ankit-buru/rice-fern-microclimate-monitor/README.md

# rice-fern-microclimate-monitor
Creating a PCB for a device to monitor the microclimate around resurrection ferns.
