ankit-buru/rice-fern-microclimate-monitor/hardware/lte_board/pcb_render_bottom.png

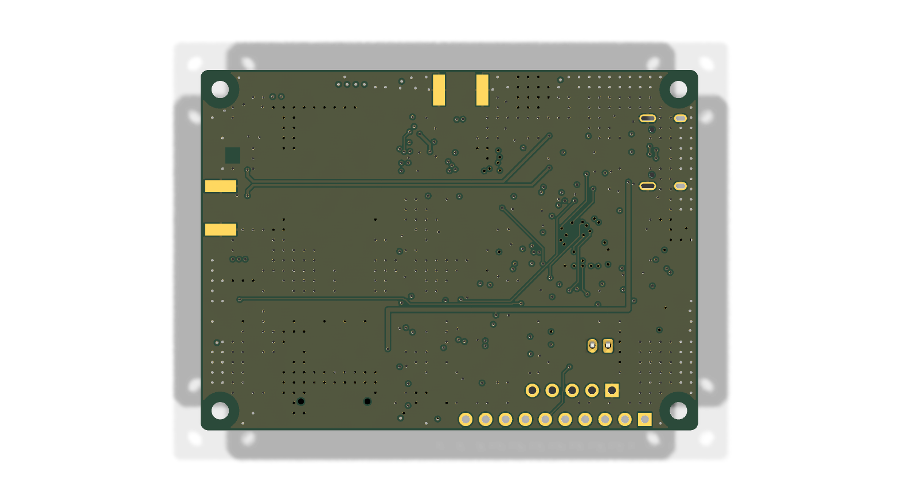
hardware/lte_board/pcb_render_bottom.png
