ankit-buru/rice-fern-microclimate-monitor/hardware/lte_board/schematic_preview.png

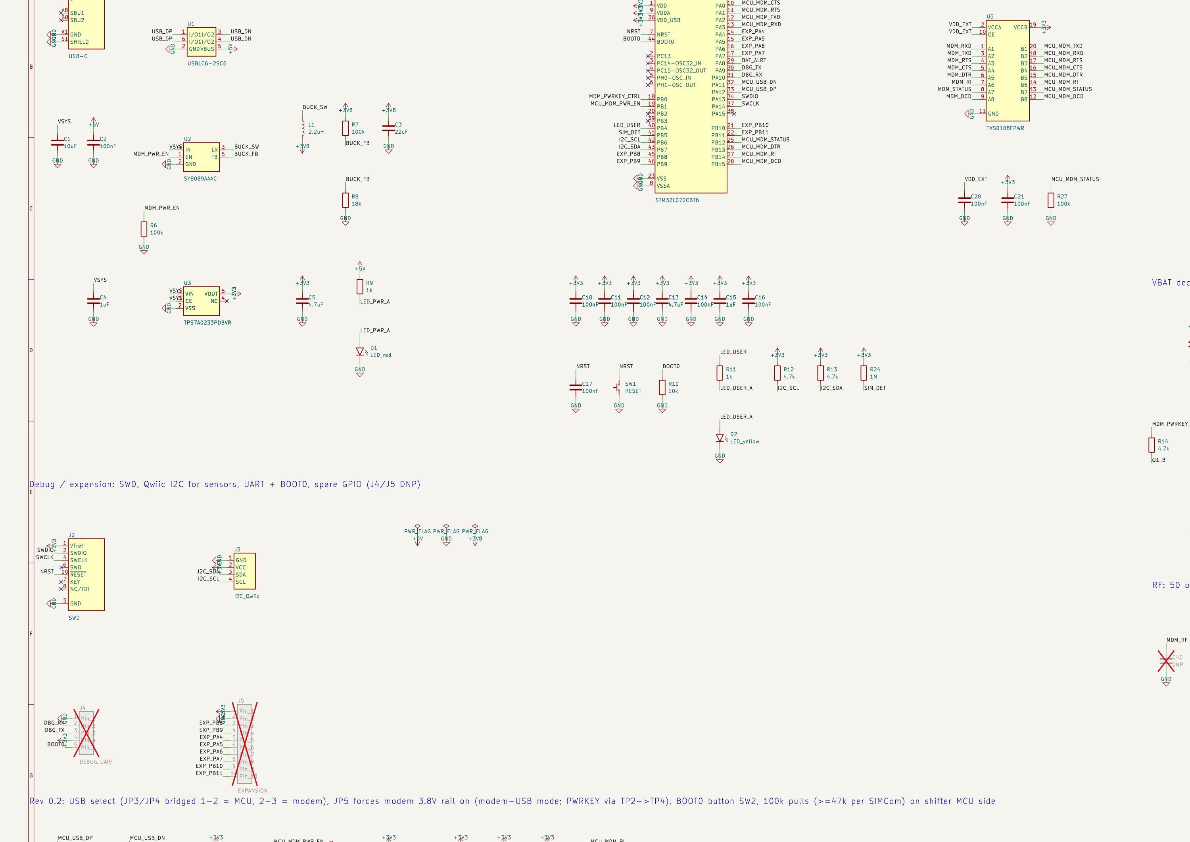
hardware/lte_board/schematic_preview.png
