ankit-buru/rice-fern-microclimate-monitor/hardware/lte_board/bom_jlcpcb.csv

Comment | Designator | Footprint | LCSC Part # | MPN | Qty
10uF | C1 | C_0805_2012Metric | C15850 | CL21A106KAYNNNE | 1
100nF | C2,C10,C11,C12,C14,C16,C17,C20,C21,C32,C35,C43,C50,C57,C60,C62 | C_0402_1005Metric | C1525 | CL05B104KO5NNNC | 16
22uF | C3 | C_0805_2012Metric | C45783 | CL21A226MAQNNNE | 1
1uF | C4,C15,C44 | C_0402_1005Metric | C52923 | CL05A105KA5NQNC | 3
4.7uF | C5,C13 | C_0603_1608Metric | C19666 | CL10A475KO8NNNC | 2
100uF | C30 | C_1206_3216Metric | C15008 | CL31A107MQHNNNE | 1
10uF | C31,C45 | C_0603_1608Metric | C19702 | CL10A106KP8NNNC | 2
33pF | C33,C51,C52,C53 | C_0402_1005Metric | C1562 | 0402CG330J500NT | 4
10pF | C34,C54,C55 | C_0402_1005Metric | C32949 | CL05C100JB5NNNC | 3
100pF | C56,C61 | C_0402_1005Metric | C1546 | 0402CG101J500NT | 2
LED_red | D1 | LED_0603_1608Metric | C2286 | KT-0603R | 1
LED_yellow | D2 | LED_0603_1608Metric | C2287 | KT-0603Y | 1
LED_green | D3 | LED_0603_1608Metric | C12624 | KT-0603G | 1
B5819W | D4 | D_SOD-123 | C8598 | B5819W SL | 1
WE05DGCF-B | D5,D8 | DFN1006-2L-BI | C3039401 | WE05DGCF-B | 2
ESD103-B1-02EL | D6 | TSLP-2-20_L1.0-W0.6-P0.65-BI | C535146 | ESD103-B1-02EL E6327 | 1
ESD5651N-2/TR | D7 | DFN1006-2L-BI-1 | C239784 | ESD5651N-2/TR | 1
USB-C | J1 | USB_C_Receptacle_HRO_TYPE-C-31-M-12 | C165948 | TYPE-C-31-M-12 | 1
SWD | J2 | PinHeader_2x05_P1.27mm_Vertical_SMD | C3975188 | PZ127-2-05-S | 1
I2C_Qwiic | J3 | JST_SH_SM04B-SRSS-TB_1x04-1MP_P1.00mm_Horizontal | C145956 | 1.0T-4P (BOOMELE) | 1
LTE_ANT | J6 | U.FL_Hirose_U.FL-R-SMT-1_Vertical | C88374 | U.FL-R-SMT-1(80) | 1
Nano-SIM | J8 | SIM-SMD_SMN-303 | C266888 | SMN-303 | 1
BATTERY | J9 | JST_PH_B2B-PH-K_1x02_P2.00mm_Vertical | C5251182 | B2B-PH-K-S-GW | 1
2.2uH | L1 | L_Sunlord_SWPA4030S | C279948 | SWPA4030S2R2NT | 1
47nH | L2 | L_0402_1005Metric | C192855 | LQW15AN47NJ00D | 1
MMBT3904 | Q1,Q2 | SOT-23 | C20526 | MMBT3904 | 2
AO3401A | Q3,Q4 | SOT-23 | C15127 | AO3401A | 2
FS8205A | Q5 | SOT-23-6 | C908265 | FS8205A | 1
5.1k | R1,R2 | R_0402_1005Metric | C25905 | 0402WGF5101TCE | 2
0R | R3,R4,R19,R20 | R_0402_1005Metric | C17168 | 0402WGF0000TCE | 4
100k | R6,R7,R25,R27,R29,R30,R31,R32,R33,R34,R37,R39 | R_0402_1005Metric | C25741 | 0402WGF1003TCE | 12
18k | R8 | R_0402_1005Metric | C25762 | 0402WGF1802TCE | 1
1k | R9,R11,R18,R28,R36 | R_0402_1005Metric | C11702 | 0402WGF1001TCE | 5
10k | R10,R26 | R_0402_1005Metric | C25744 | 0402WGF1002TCE | 2
4.7k | R12,R13,R14,R16 | R_0402_1005Metric | C25900 | 0402WGF4701TCE | 4
47k | R15,R17 | R_0402_1005Metric | C25792 | 0402WGF4702TCE | 2
22R | R21,R22,R23 | R_0402_1005Metric | C25092 | 0402WGF220JTCE | 3
1M | R24 | R_0402_1005Metric | C26083 | 0402WGF1004TCE | 1
100R | R35 | R_0402_1005Metric | C25076 | 0402WGF1000TCE | 1
10R | R38 | R_0402_1005Metric | C25077 | 0402WGF100JTCE | 1
RESET/BOOT0 | SW1,SW2 | SW_TS-1187A | C318884 | TS-1187A-B-A-B | 2
USBLC6-2SC6 | U1 | SOT-23-6 | C7519 | USBLC6-2SC6 | 1
SY8089AAAC | U2 | SOT-23-5 | C78988 | SY8089AAAC | 1
TPS7A0233PDBVR | U3 | SOT-23-5 | C2887324 | TPS7A0233PDBVR | 1
STM32L072CBT6 | U4 | LQFP-48_7x7mm_P0.5mm | C465977 | STM32L072CBT6 | 1
TXS0108EPWR | U5 | TSSOP-20_4.4x6.5mm_P0.65mm | C17206 | TXS0108EPWR | 1
SIM7080G | U6 | SIM7080G | C2943992 | SIM7080G | 1
ESDA6V1W5 | U7 | SOT-353_SC-70-5 | C48677 | ESDA6V1W5 | 1
MAX17048G+T10 | U8 | MAX17048_TDFN-8_2x2mm | C2682616 | MAX17048G+T10 | 1
DW01A | U9 | SOT-23-6 | C351410 | DW01A | 1
TPS22945 | U10 | SC-70-5_L2.1-W1.3-P0.65-LS2.1-BL | C47507 | TPS22945DCKR | 1
32.768kHz | Y1 | Crystal_SMD_3215-2Pin_3.2x1.5mm | C97604 | SC-32S 32.768kHz 20PPM 7pF | 1
