ankit-buru/rice-fern-microclimate-monitor/(commit log)

2026-10-13 Add LTE-M sensor board (STM32L072 + SIM7080G), KiCad rev 0.3
    KiCad 8/9 project for a battery-powered LTE-M/NB-IoT logger for the
    fern microclimate monitor: STM32L072CBT6 (USB DFU bootloader) driving a
    SIMCom SIM7080G modem, Qwiic I2C for sensors, 1-cell Li-ion input
    (18650s in parallel) on a JST PH connector with reverse-polarity and
    DW01A/FS8205A protection, MAX17048 fuel gauge, and USB/battery OR-ing.
    - 63.5 x 46 mm, 4 layers, single-sided SMD assembly (+ THT battery
    connector), four M2 corner holes; DRC clean, matches the schematic
    - bom_jlcpcb.csv / cpl_jlcpcb.csv generated from the design and checked
    to list the same 92 parts, all with LCSC numbers
    - layout_scripts/ holds the place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
2026-10-13 Add design document, agent notes, and a reproducible layout pipeline
    - hardware/lte_board/DESIGN.md: requirements, architecture, decision log
    with rationale and rejected alternatives, power budget, PCB rules,
    layout toolchain, lessons learned, firmware requirements, open items,
    references
    - CLAUDE.md: entry point for AI agents (where things are, rules,
    verification)
    - layout_scripts/pipeline.sh: runs placement -> hand routes ->
    Freerouting (best of N) -> maze-router finish -> clean-ups -> DRC ->
    JLC BOM/CPL; fails loudly if Freerouting produces no session
    - gen_board.py: KICAD9_FOOTPRINT_DIR override for the footprint library
    - maze_route.py / final_fixes.py: use GetWidth(layer)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
2026-10-28 reformat/update task list; minor schematic changes
2026-10-30 Fix SIM holder access: clear the card slot, keep copper off the springs
    The rev 0.3 layout put D4/Q4/R34 (USB/battery OR-ing) and U3/C4/C5 (3.3V
    LDO) directly in front of the nano-SIM holder's card opening, which
    blocked insertion, and ran GND pour, stitching vias and SIM traces under
    the holder's contact springs.
    Checked against the XunPu SMN-303 manufacturer drawing (Rev A):
    - J8 moved down so its opening is ~1.3 mm from the bottom edge (the card
    ejects ~4.2 mm, so it can be gripped); nothing is in front of it
    - D4/Q4/R34 moved between SW2 and the holder; U3/C4/C5 to the
    bottom-right corner by the buck; +5V highway re-ended at D4
    - six F.Cu keep-outs (no tracks/vias/pour) for the draw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
2026-10-30 Move SIM holder 1 mm inward so the locked card sits fully over the PCB
    Owner's choice after reviewing the SMN-303 drawing's lock (1.50 +/- 0.3 mm)
    and eject (4.20 +/- 0.5 mm) positions:
    - J8 front face now 2.35 mm from the bottom edge: locked card end ~0.85 mm
    inside the edge, ejected card ~1.85 mm past it (still grippable)
    - Q4 nudged 0.2 mm left to clear J8's ground tab
    - DESIGN.md: corrected the SIM edge-distance numbers (the earlier
    "0.4 mm" referred to the pads, not the front face)
    - pipeline.sh: save the .kicad_pro at the start and restore it (plus our
    rules) at the end, so KiCad GUI settings survive a regeneration
    Re-routed with pipeline.sh: DRC 0 violations, 0 unconnected, 0 s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
2026-11-01 Pre-fab audit fixes (rev 0.4) and antenna rework (rev 0.5)
    Rev 0.4, from the independent design audit:
    - No vias in SMD pads: stitch.py, final_fixes.py and maze_route.py keep vias
    0.1 mm clear of every SMD pad, the DSN sets via_at_smd off, and the new
    check_via_in_pad.py runs at the end of pipeline.sh (0 found).
    - JLC rotations: make_jlc.py applies a per-LCSC-number JLC_CORR table
    (rotation + origin offset fitted against each part's EasyEDA footprint),
    and fails on a non-passive part without an entry. Fixes J9 polarity.
    - 32.768 kHz LSE crystal Y1 (Seiko SC-32S, 7 pF, C97604) with 10 pF C54/C55
    on PC14/PC15.
    - L1 on Sunlord's recommended SWPA4030S land (new footprint).
    - AN2606 che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
2026-11-01 lte_board rev 0.6: impedance widths for JLC default stackup, audit H10 fixes
    - RF traces 0.30 mm (~49 ohm), modem USB pair 0.25/0.20 mm (~92 ohm diff)
    on JLC04161H-7628 (no impedance control ordered)
    - H10a: C62 100 nF at U5 VCCA
    - H10d: SIM caps C50-C53 and ESD array U7 moved next to the holder
    - H10e: keep-out over the SIM7080G forbidden area (HD V1.05 Fig. 4)
    - H10g: D7 ESD5651N-2/TR VBAT TVS, D8 WE05DGCF-B on PWRKEY
    - H10h: C1 10 uF 25 V 0805 (C15850)
    - crystal Y1 copper keep-out; MAX17048 land per Maxim 90-0065
    - RESET/BOOT0 silkscreen labels on SW1/SW2
    - docs: stackup/impedance, LSE drive must be medium-high or high
    ERC 0; DRC 0/0/0 with schematic parity; BOM/CPL 107/107.
    Co-Author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
